fabloch/Tetris-Led/README.md

# Tetris-Led

Voila un tutoriel pour réaliser un Tetris affichage LED. 
Le tuto est visible ici mais il faut télécharger le .Zip pour récupérer les fichier en SVG.
